brucejcooper/somfy-rts-board/3dshapes/README.md

# 3D models

Put the ESP32-DevKitC vendor model here as `ESP32-DevKitC-32D.step` - see the main README
("ESP32-DevKitC 3D model"). It is not included because its licence does not allow redistribution.
