brucejcooper/somfy-rts-board/case/renders/3-bottom-ports.png

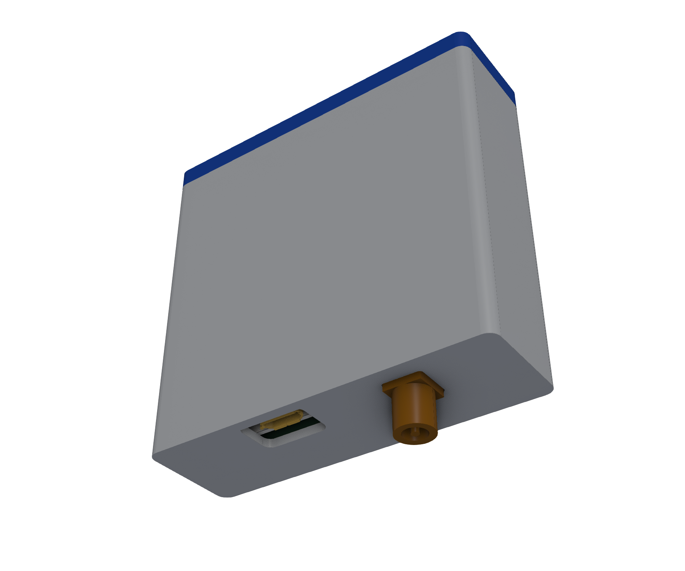
case/renders/3-bottom-ports.png
