brucejcooper/somfy-rts-board/case/renders/4-exploded.png

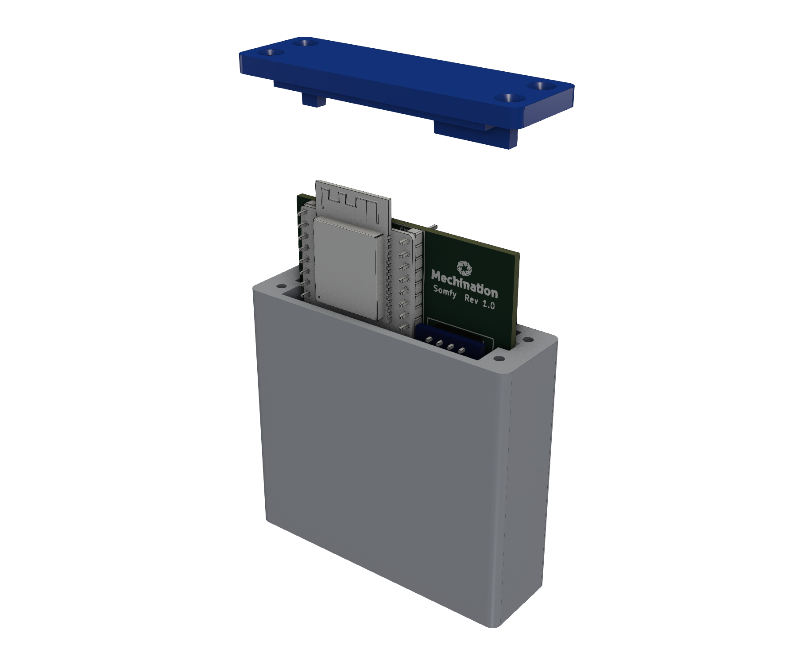
case/renders/4-exploded.png
