brucejcooper/somfy-rts-board/case/renders/5-open-top.png

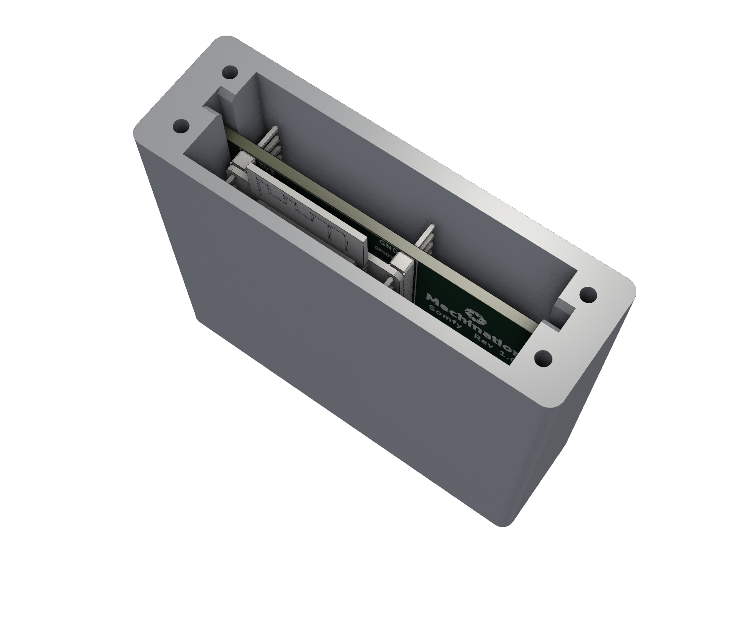
case/renders/5-open-top.png
