brucejcooper/somfy-rts-board/case/SomfyCase-lid.step

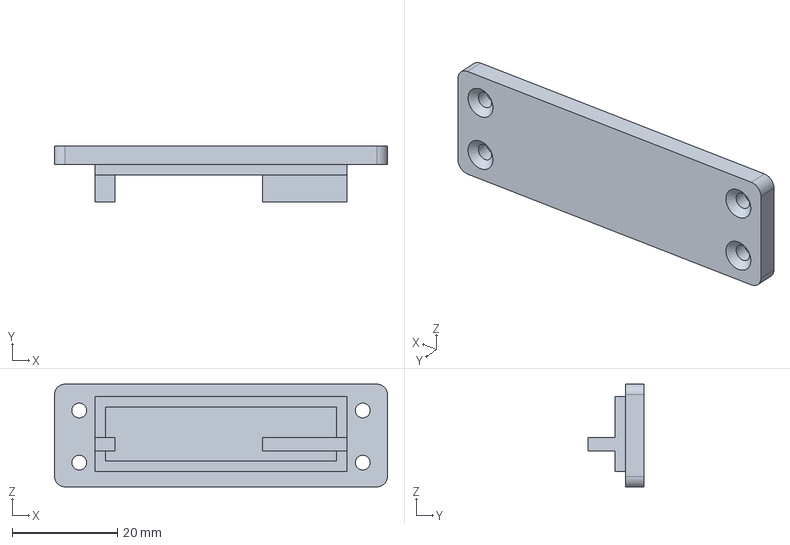
[picture p7: CAD file, 2026-10-05]
case/SomfyCase-lid.step
63.2 x 10.6 x 19.5 mm
