brucejcooper/somfy-rts-board/case/SomfyCase-body.step

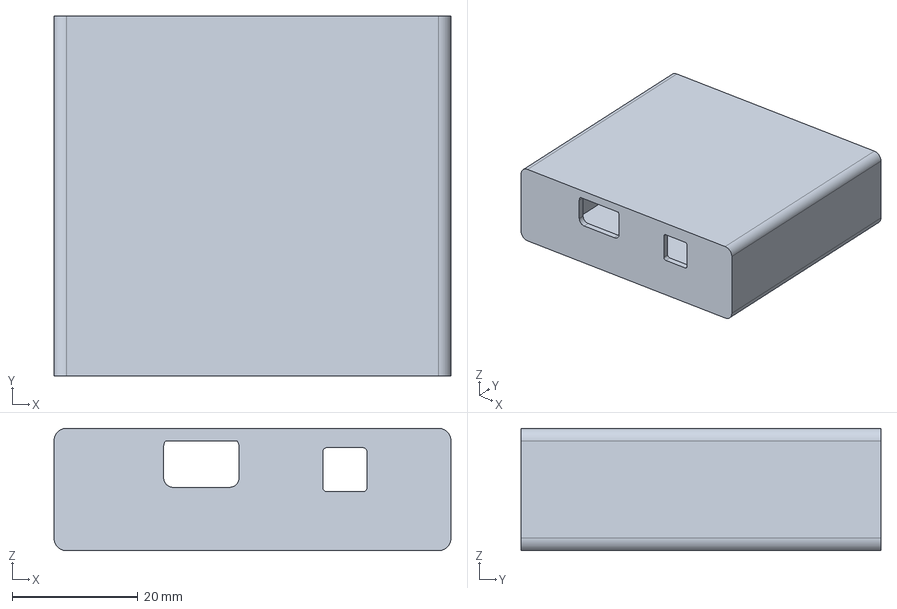
[picture p8: CAD file, 2026-10-05]
case/SomfyCase-body.step
63.2 x 57.3 x 19.5 mm
