brucejcooper/somfy-rts-board/(list of files, cad)

Other CAD files:
case/SomfyCase-body.stl
case/SomfyCase-lid.stl
