brucejcooper/somfy-rts-board/Somfy.kicad_sch

## KiCad design Somfy.kicad_sch (2026-10-05)

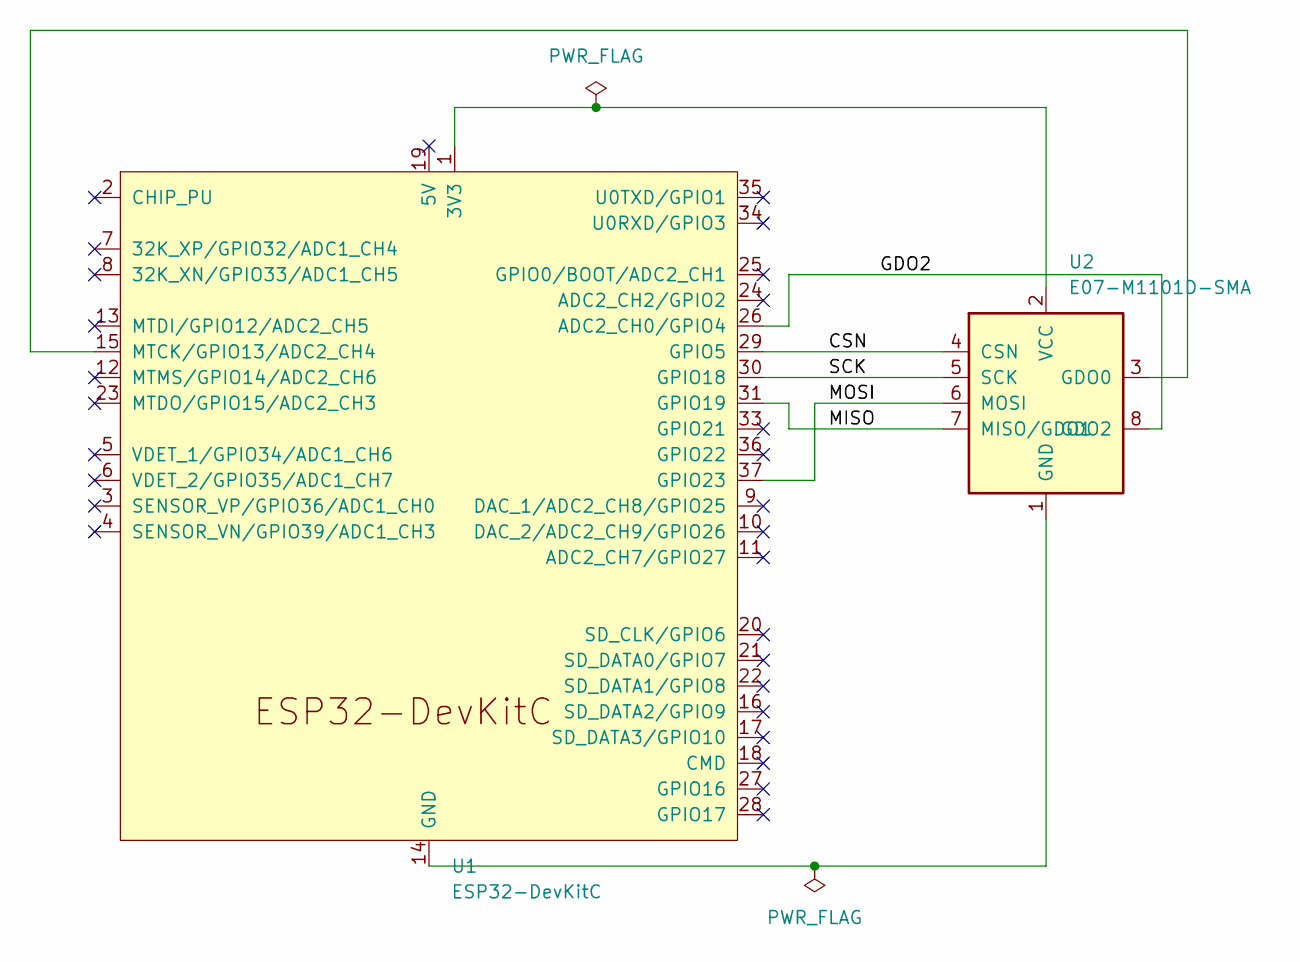
[picture p9: schematic Somfy.kicad_sch]

Parts:
U1: ESP32-DevKitC
U2: E07-M1101D-SMA

Connections:
CSN: U1.29 (GPIO5), U2.4 (CSN)
GDO2: U1.26 (ADC2_CH0/GPIO4), U2.8 (GDO2)
MISO: U1.31 (GPIO19), U2.7 (MISO/GDO1)
MOSI: U1.37 (GPIO23), U2.6 (MOSI)
unnamed: U1.1 (3V3), U2.2 (VCC)
unnamed: U1.14 (GND), U1.32 (GND), U1.38 (GND), U2.1 (GND)
unnamed: U1.15 (MTCK/GPIO13/ADC2_CH4), U2.3 (GDO0)
SCK: U1.30 (GPIO18), U2.5 (SCK)
