brucejcooper/somfy-rts-board/(commit log)

2026-10-05 Somfy RTS radio board rev 1.0 and slide-in case
    KiCad 10 carrier board for an ESP32-DevKitC and an Ebyte E07-M1101D-SMA
    CC1101 module (ESPSomfy RTS), with project-local symbols, footprints and
    3D models, Mechination branding, and slide rails for the case.
    The case is modelled in build123d (case/make_case.py) with a live browser
    viewer, fit and printability checks, and renders, all run through uv.
    [Somfy.kicad_pcb, Somfy.kicad_sch, SomfyCase-body.step, SomfyCase-body.stl, SomfyCase-lid.step, SomfyCase-lid.stl]
2026-10-05 Make the case model self-explaining for future changes
    - make_case.py: every remaining literal is now a named, commented setting
    (lead-in, opening radii, prong clearances, screw height, modelling
    tolerances); output geometry is unchanged. Fix stale FreeCAD references.
    - check_case.py: re-measure the component envelope from the board export
    and report any hard-coded measurement in make_case.py that has gone stale.
    - CLAUDE.md: design intent, constraints and their reasons, workflow and
    tooling traps for future Claude Code sessions.
    [SomfyCase-body.step, SomfyCase-lid.step]
